nurRatul/Project-A7/Resources/Images/pi5.jpg

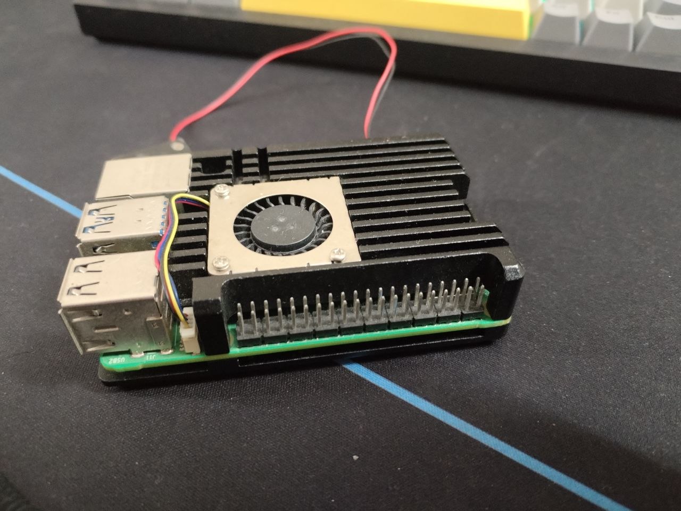
Resources/Images/pi5.jpg
