nurRatul/Project-A7/Vouchers/week-4 costy.jpg

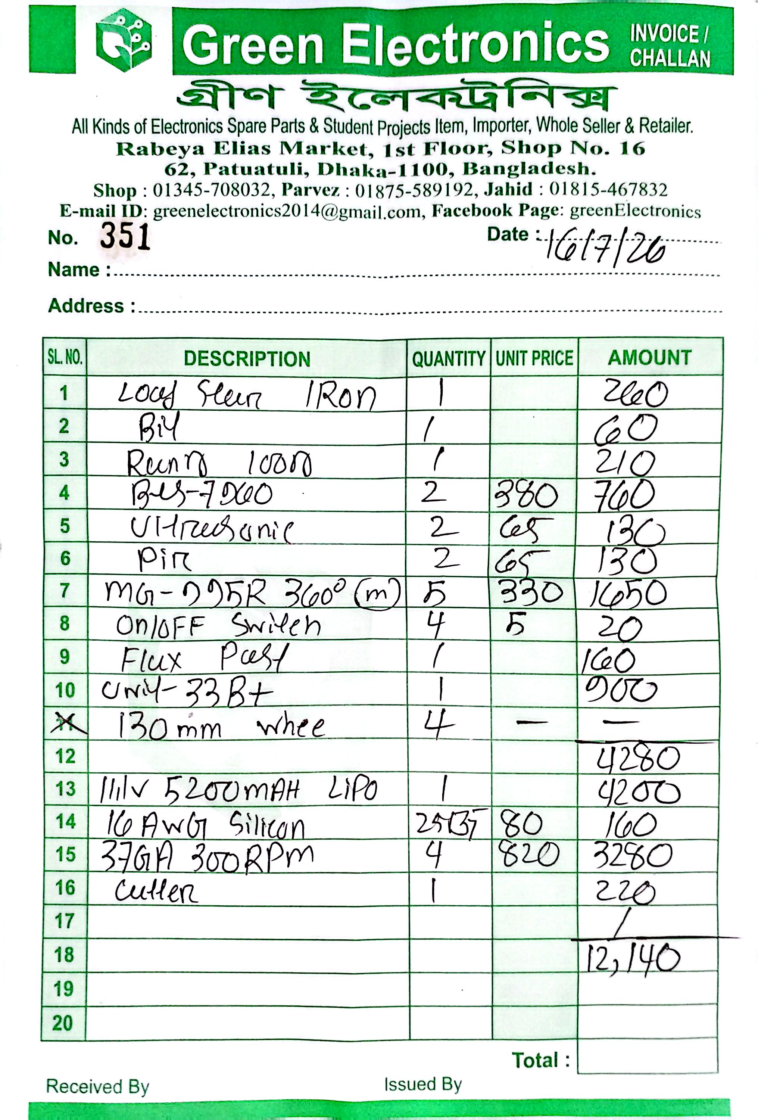
Vouchers/week-4 costy.jpg
