nurRatul/Project-A7/README.md

# Project-A7
A Garbage Collecting Rover that Collects the Garbage from the Sea Beatch.
