nurRatul/Project-A7/Codes/tasks.md

## Everytime you have to do
- read all given files and understand the code. 

## Ultimate Goal
- Detect object location and grab it using the physical robotic arm.

## First task
- read the arduino code and give the solution to the file not found or run and debug
