nurRatul/Project-A7/Weekly Report/WEEk-06.pdf

Group: A7 | Week 06 | 03/08/2026

## Progress This Week

1. Drilled some holes in the chassis for mounting of the motor and the arm.
2. Assembled the chassis with the wheels.
3. Assembled the arm with the gripper.

## Problem faced:

1. There were some dimensional errors of the holes for mounting the motor on the chassis. Some holes were out of found for bolting.
2. We 3D printed the arm so there were some problems with the holes as expected. Some 3 mm holes got smaller.
3. Also the reference dimension we took for the motor fitting in the arm had some error.

## How the problems were solved:

1. Although there were slight errors of the location of the hole in the motor mounting, 3 out of 6 holes were perfectly aligned which should give decent stability and strength.
2. We had to use different size of bolts to assemble the arm. In some case we drilled some holes for assembly.
3. We had to cut some portion of the motor mounting in the arm to perfectly fit the motor.
