nurRatul/Project-A7/Team-Ǎ7 Presentetion Slide.pptx

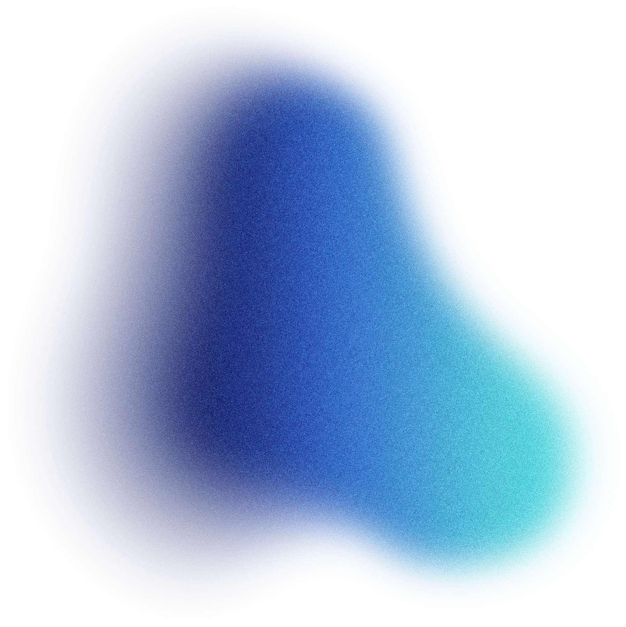
[picture p31: figure]

Team-A7

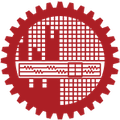
[picture p32: figure]

Garbage collection System

Presented by

Ahmed Nur Ratul
Md Rakibul Islam

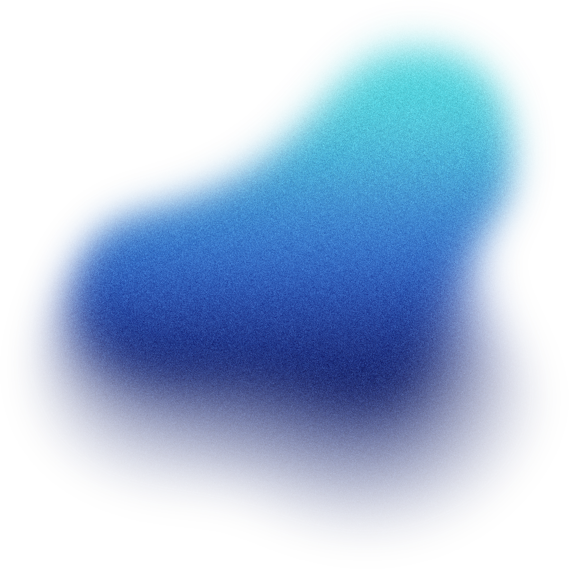
[picture p33: figure]

Editted By Nur Ratul

Date

03 August 2026

Website

https://github.com/nurRatul/Project-A7

E-mail

ratulnur9435@gmail.com

## Slide 2

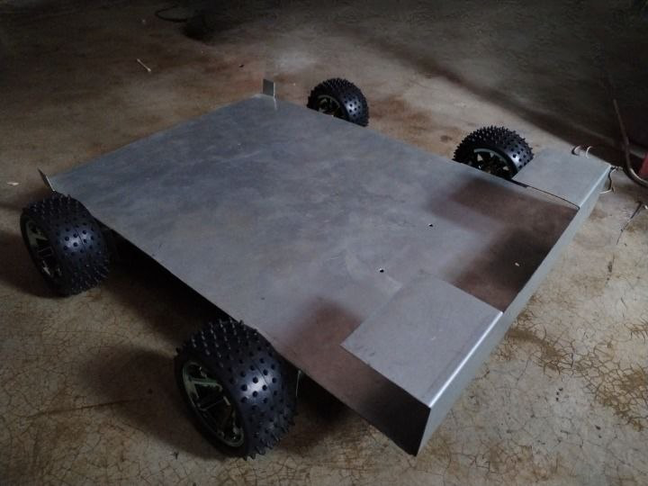
[picture p34: figure]

## Slide 3

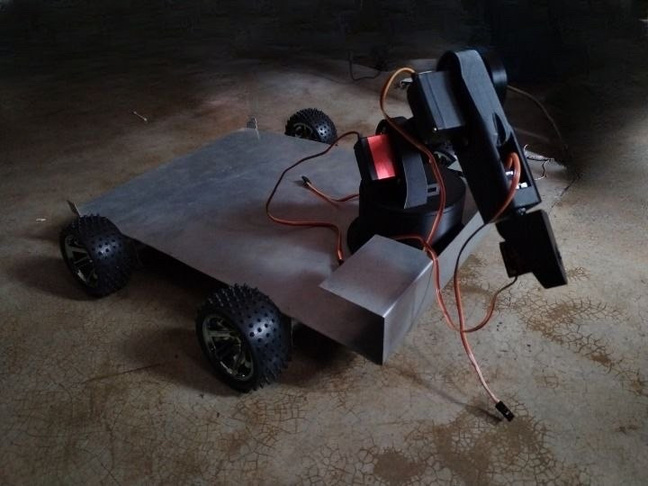
[picture p35: figure]

## Slide 4

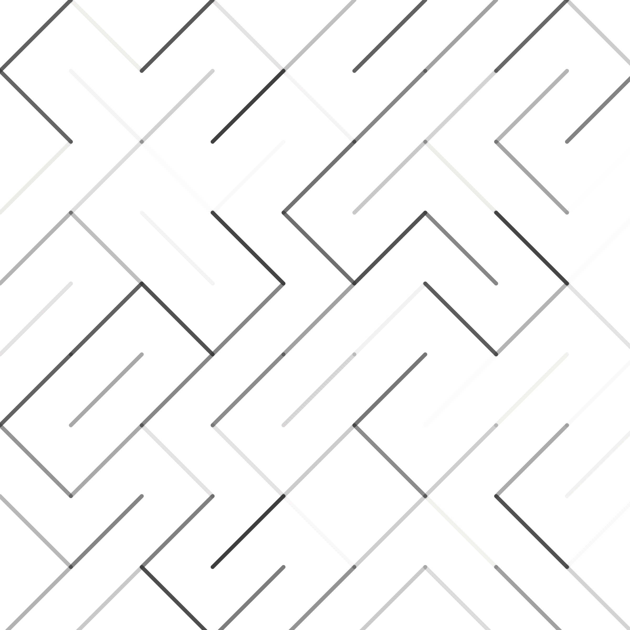
[picture p36: figure]

THANK
YOU

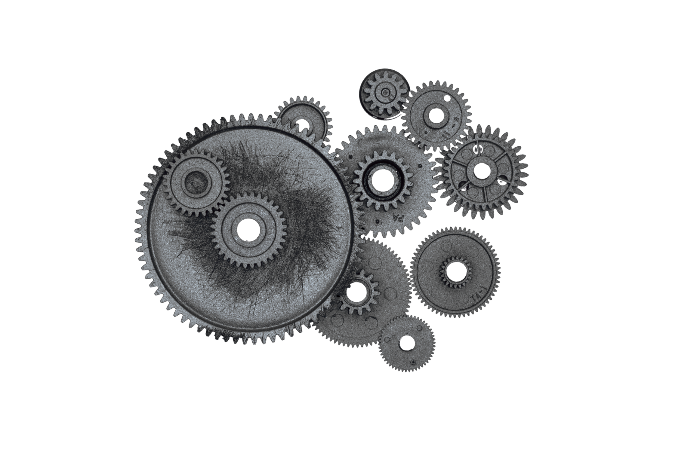
[picture p37: figure]
