nurRatul/Project-A7/Resources/Others/Team-Ǎ7 Presentetion Slide.pptx

Team-A7


Garbage collection System

Presented by

Ahmed Nur Ratul
Md Rakibul Islam


Editted By Nur Ratul

Date

03 August 2026

Website

https://github.com/nurRatul/Project-A7

E-mail

ratulnur9435@gmail.com

## Slide 2


## Slide 3


## Slide 4


THANK
YOU
