nurRatul/Project-A7/Codes/markers/marker_4.png

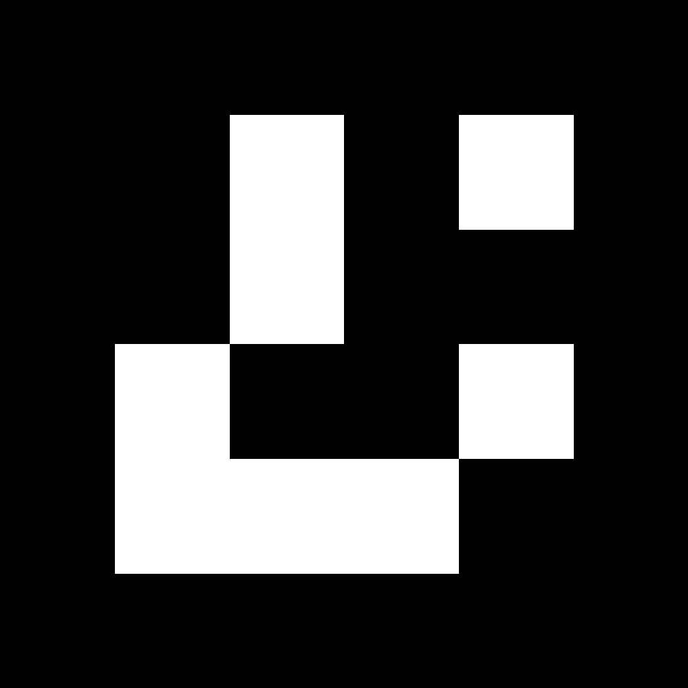
Codes/markers/marker_4.png
