nurRatul/Project-A7/Codes/markers/markers_sheet.png

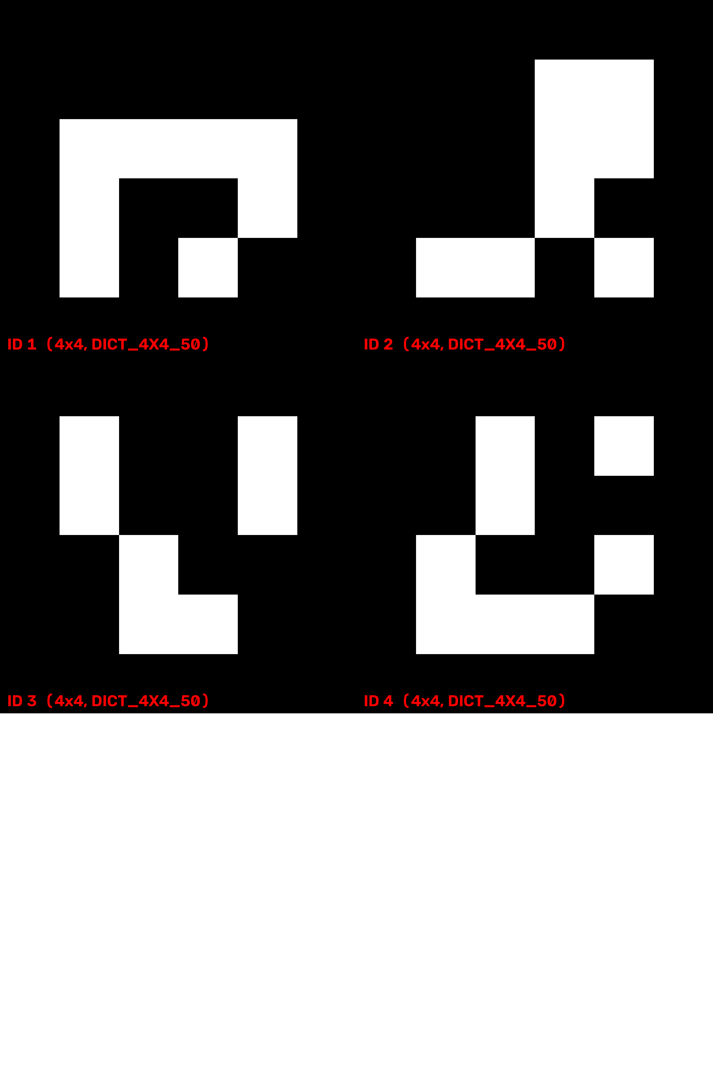
Codes/markers/markers_sheet.png
