nurRatul/Project-A7/Codes/objects/object1.jpg

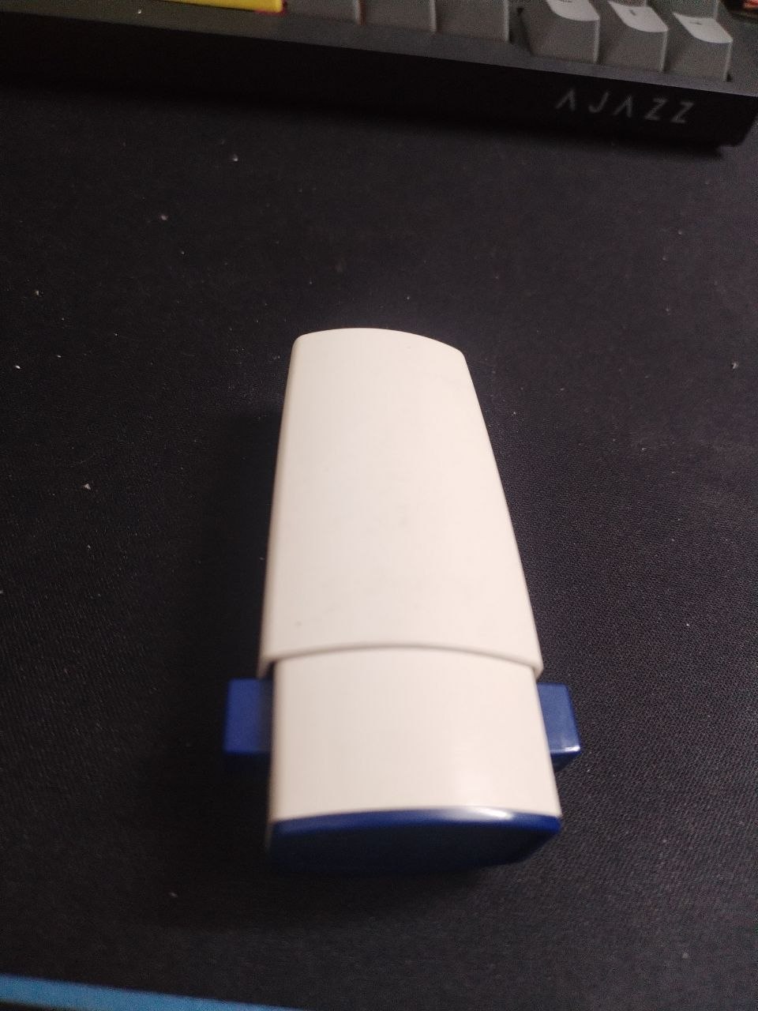
Codes/objects/object1.jpg
