nurRatul/Project-A7/Components_List_From_Invoice.docx

# Components List

SL No | Component Name | Quantity | Unit Price (BDT) | Amount (BDT)
1 | Lead Solder Iron | 1 | | 260
2 | Bit (Soldering Bit) | 1 | | 60
3 | Round 100Ω Resistor | 1 | | 210
4 | BTS-7960 Motor Driver | 2 | 380 | 760
5 | Ultrasonic Sensor | 2 | 65 | 130
6 | PIR Sensor | 2 | 65 | 130
7 | MG-995R 360° Servo Motor | 5 | 330 | 1650
8 | ON/OFF Switch | 4 | 5 | 20
9 | Flux Paste | 1 | | 160
10 | LM324 IC (verify from invoice) | 1 | | 900
11 | 130 mm Wheel | 4
13 | 11.1V 5200mAh LiPo Battery | 1 | | 4200
14 | 16 AWG Silicone Wire | 2 m | 80 | 160
15 | 37GA 300 RPM DC Gear Motor | 4 | 820 | 3280
16 | Cutter | 1 | | 220
