nurRatul/Project-A7/Resources/Cad Models/piboxface1.SLDPRT

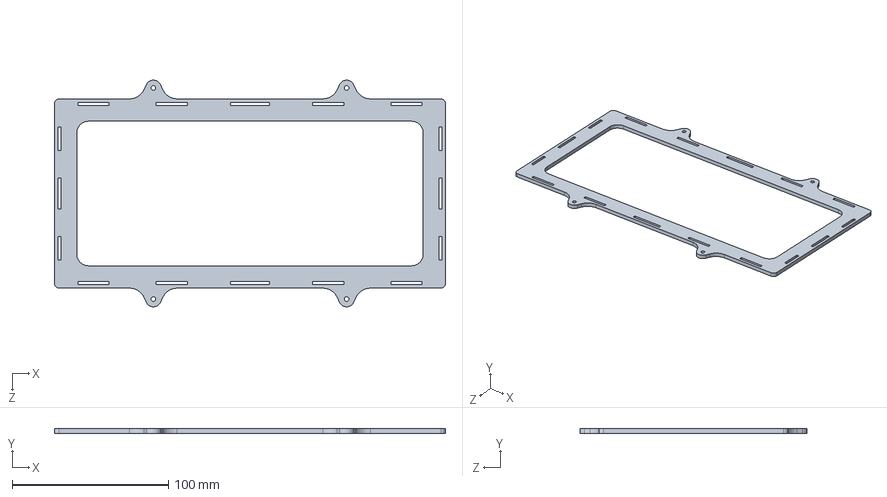
[picture p41: CAD file, 2026-08-02]
Resources/Cad Models/piboxface1.SLDPRT
250.0 x 3.00 x 144.9 mm
