nurRatul/Project-A7/Resources/Cad Models/frontchasis1.SLDPRT

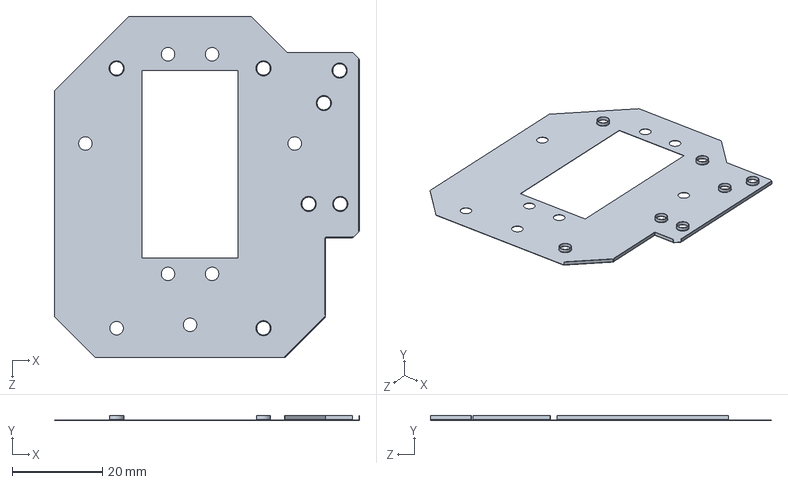
[picture p42: CAD file, 2026-08-02]
Resources/Cad Models/frontchasis1.SLDPRT
67.5 x 1.00 x 75.5 mm
