nurRatul/Project-A7/Resources/Cad Models/piboxface3.SLDPRT

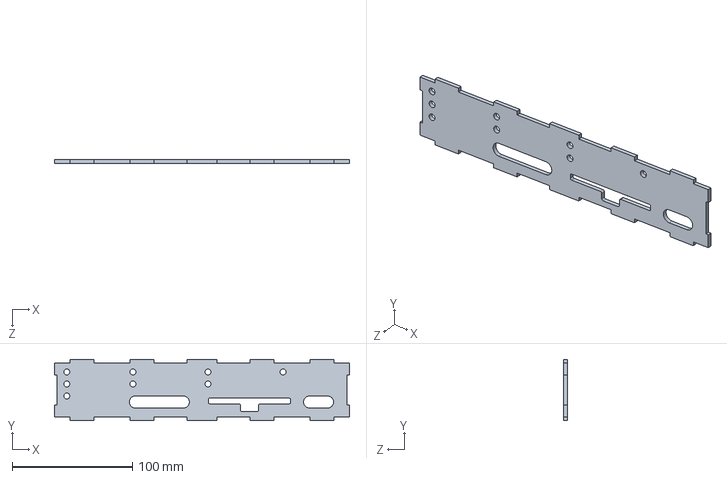
[picture p44: CAD file, 2026-08-02]
Resources/Cad Models/piboxface3.SLDPRT
245.5 x 51.0 x 3.00 mm
