nurRatul/Project-A7/Resources/Cad Models/piboxface2.SLDPRT

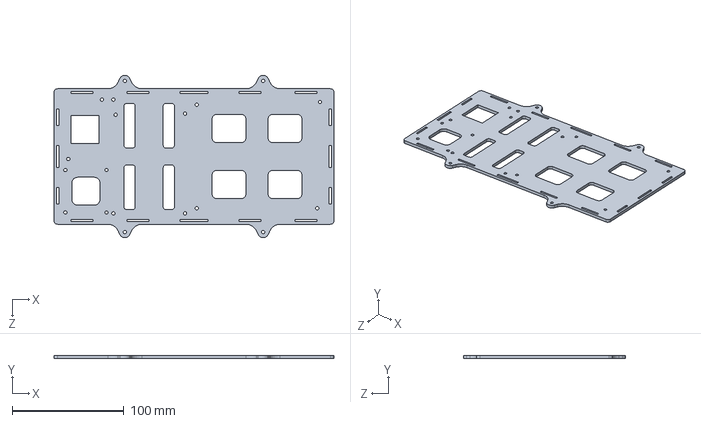
[picture p45: CAD file, 2026-08-02]
Resources/Cad Models/piboxface2.SLDPRT
250.0 x 3.00 x 144.9 mm
