nurRatul/Project-A7/Resources/Cad Models/piboxface6.SLDPRT

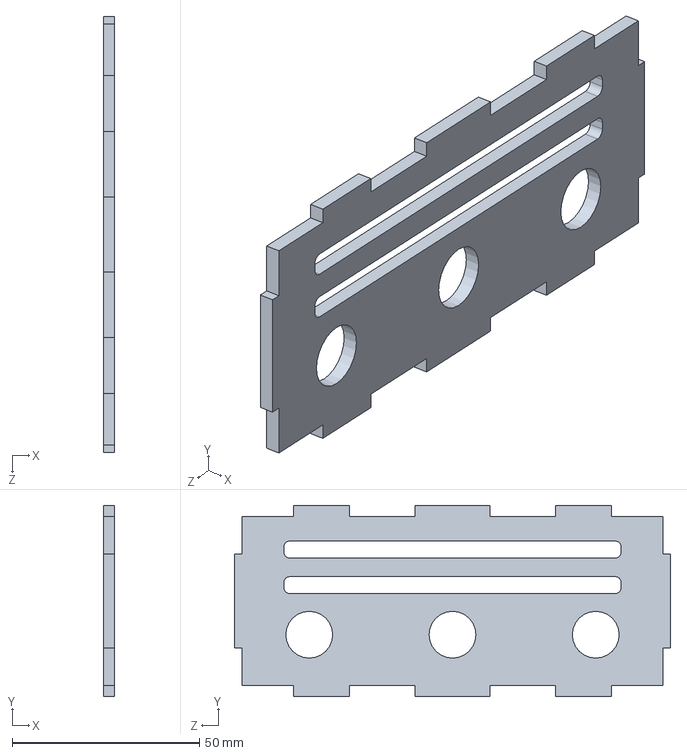
[picture p46: CAD file, 2026-08-02]
Resources/Cad Models/piboxface6.SLDPRT
3.00 x 51.0 x 116.5 mm
