nurRatul/Project-A7/Resources/Cad Models/piboxface4.SLDPRT

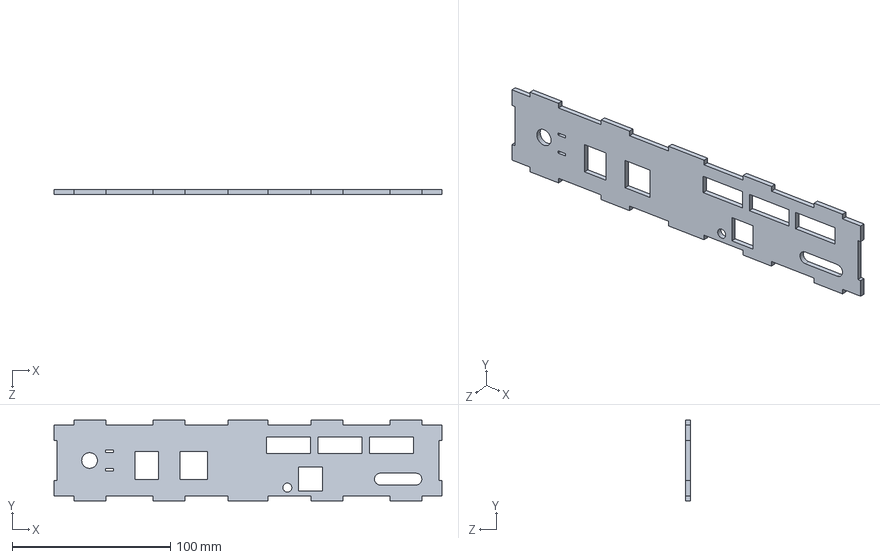
[picture p47: CAD file, 2026-08-02]
Resources/Cad Models/piboxface4.SLDPRT
245.5 x 51.0 x 3.00 mm
