nurRatul/Project-A7/Resources/Cad Models/upperwheelcircle1.SLDPRT

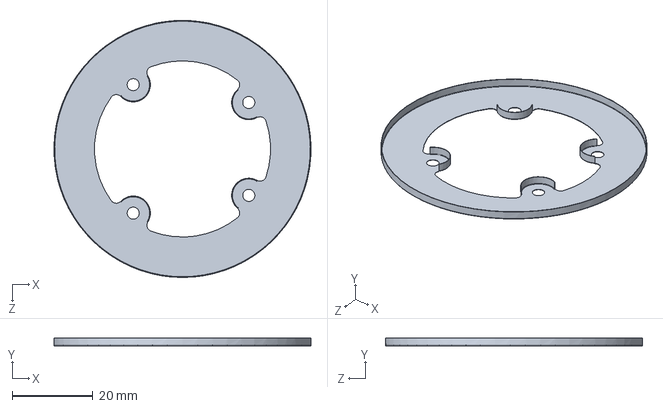
[picture p48: CAD file, 2026-08-02]
Resources/Cad Models/upperwheelcircle1.SLDPRT
63.5 x 2.00 x 63.5 mm
