nurRatul/Project-A7/Codes/final_test.py

from Arm import Controller


controller = Controller(
    show_video=True,
    debug=True,
    enable_motion=True
)
controller._open_serial()
controller.home()

try:

    while True:

        angles = controller.update()

        if angles is not None:

            print("ARM ANGLES:", angles)
            controller.write_arduino([angles[0], angles[1], angles[2], 0, angles[1]-angles[2]+90, 100])

            # Your arm code here
            # arm.move(angles)


except KeyboardInterrupt:

    pass

finally:

    controller.close()
