nurRatul/Project-A7/(commit log)

2026-08-02 Add files via upload
    Cad model of pibox
    [frontchasis1.SLDPRT, piboxface1.SLDPRT, piboxface2.SLDPRT, piboxface3.SLDPRT, piboxface4.SLDPRT, piboxface5.SLDPRT, piboxface6.SLDPRT, upperwheelcircle1.SLDPRT]
2026-08-02 Added Cost Sheet
    [CostSheet.xlsx]
2026-08-10 Starting Coding
    [CostSheet.xlsx]
2026-08-10 trial and error -01: arm not calculatingany near position
    [generate_markers.py, test.py]
2026-08-10 te 2: 'p' not working
    [test.py]
2026-08-14 te-02: ik angle 2,3 not working exactly
    [controller.py, test_final.py]
2026-08-26 Add camera calibration script
    This script captures images of a checkerboard for camera calibration, processes the images to find corners, and computes the camera matrix and distortion coefficients.
2026-08-27 Update controller for ultrasonic integration- from Claude
    Refactor controller to integrate ultrasonic sensors and Arduino communication.
2026-08-27 Refactor inverse kinematics in ik.py- From Claude
    Refactor inverse kinematics calculations for the arm. Removed unnecessary parameters and adjusted angle calculations to match new geometry.
2026-08-27 Ultrasonic integration
2026-08-27 testing the imu sensor
2026-08-27 debug the local import error
    [carController.py, test.py]
2026-08-27 debug the local import error
    [carController.py]
2026-08-27 debug loclal import error
    [test.py]
2026-08-27 locla import error debug
    [mpu6050.py, test.py]
2026-08-27 debug local import error
    [carController.py, test.py]
2026-08-27 changed the output message of the imu sensor
2026-08-27 Add positioning test for camera pixel classification
    This script tests the classification of camera pixel positions relative to an ultrasonic sensor selection based on predefined thresholds.
2026-08-30 added visuals in a local webpage
    [CostSheet.xlsx]
2026-09-03 Implement home method to send home commanded and arduino send code
    Added a home method to send a home command to Arduino.
2026-09-03 calibrate the left angle
2026-09-03 Add camera calibration script using checkerboard pattern
    This script captures images from a camera and calibrates it using a checkerboard pattern. It saves the calibration data to a JSON file.
2026-09-03 tuned for one ultrasonic sensor (important to change back)
2026-09-09 test the arm
2026-09-10 set the chang in pin of uno solved by for loop
    [arm_test.py]
2026-09-10 corrected the uno port and the grabber alays downward and theta2 angle
    [arm_test.py, controller.py, ik.py]
2026-09-10 implemented write arduino in the controller
2026-09-10 autofocus and major changes in camera settings
2026-09-11 combining arm with the car
2026-09-11 changed the ultrasonic from the arm to rover
2026-09-11 add right move in arm
2026-09-12 corrected the arm controller a bit
    [armcontroller.py]
2026-09-12 major change, go back if not work
    [detector.py, detectorManager.py, interfaces.py, videoStream.py]
2026-09-12 applied low pass filter of 21 hz in mpu6050
2026-09-12 return the arduino code back
2026-09-12 lower grade the camera
2026-09-13 arm grab
